HUANG-Haolun/Jerry_Duck/jduck_description/meshes/neck_pitch_link.STL

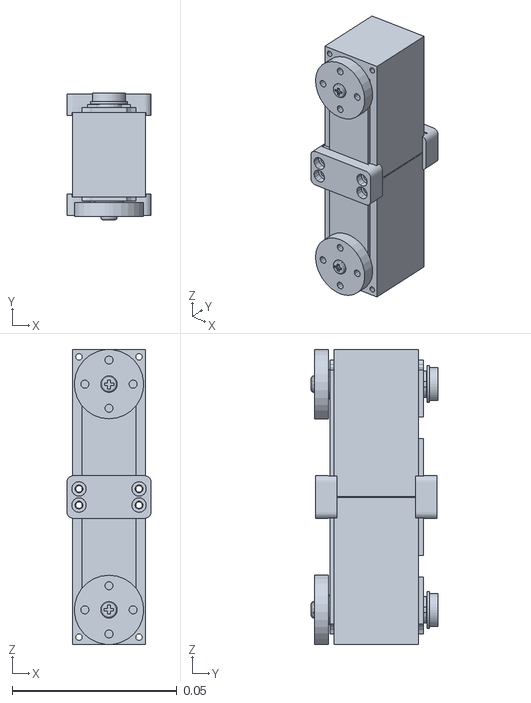
[picture p1: CAD file, 2026-11-02]
jduck_description/meshes/neck_pitch_link.STL
0.0255 x 0.0384 x 0.0894
