HUANG-Haolun/Jerry_Duck/jduck_description/meshes/head_yaw_link.STL

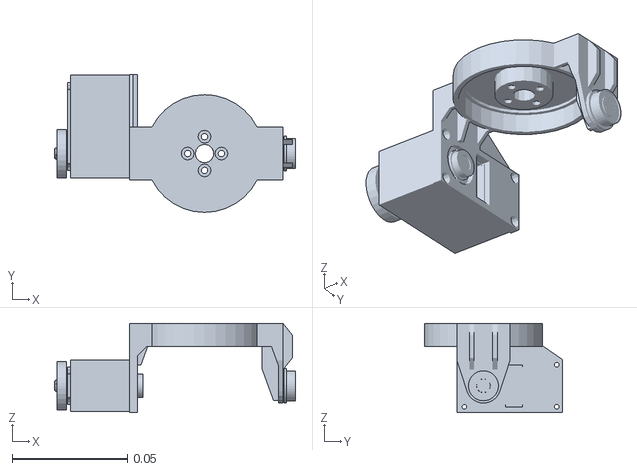
[picture p2: CAD file, 2026-11-02]
jduck_description/meshes/head_yaw_link.STL
0.104 x 0.0597 x 0.0386
