HUANG-Haolun/Jerry_Duck/jduck_description/meshes/mouth_link.STL

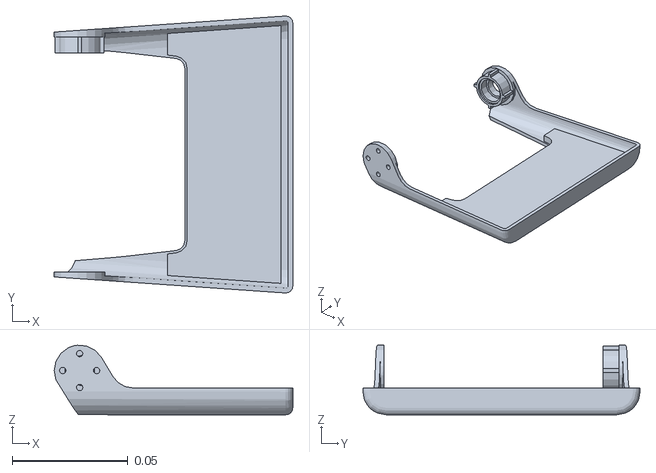
[picture p3: CAD file, 2026-11-02]
jduck_description/meshes/mouth_link.STL
0.103 x 0.12 x 0.0301
