HUANG-Haolun/Jerry_Duck/jduck_description/meshes/right_hip_roll_link.STL

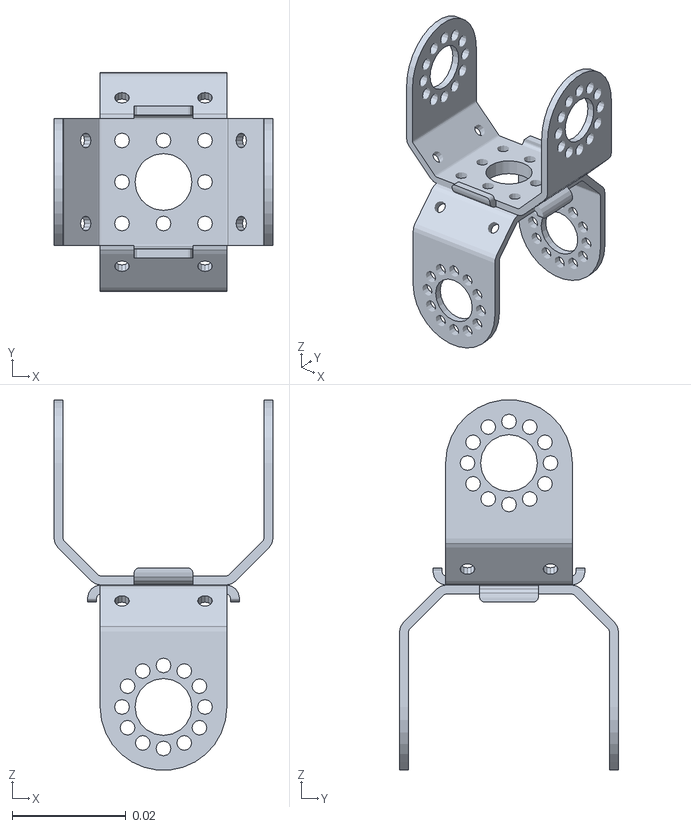
[picture p4: CAD file, 2026-11-02]
jduck_description/meshes/right_hip_roll_link.STL
0.0385 x 0.0385 x 0.0651
