HUANG-Haolun/Jerry_Duck/jduck_description/meshes/right_knee_link.STL

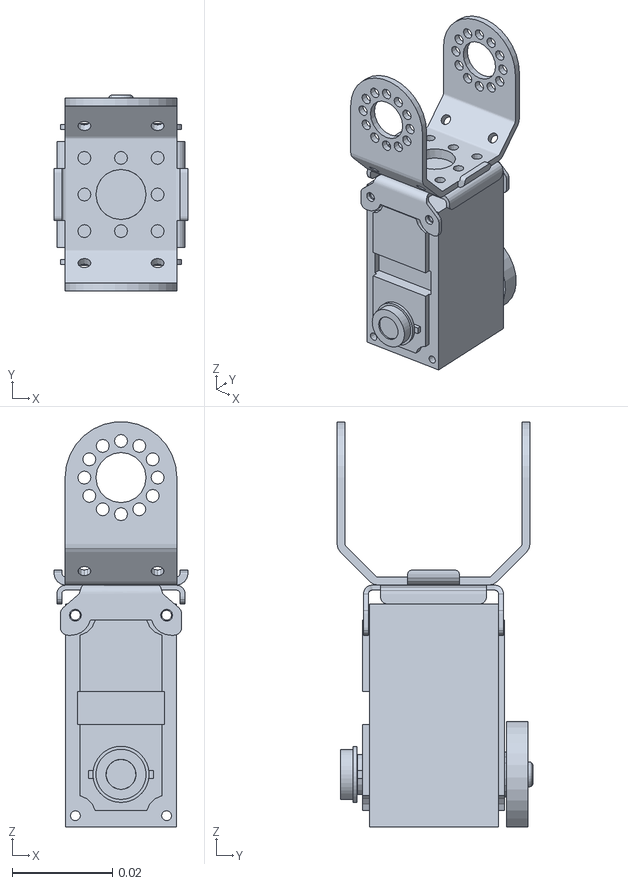
[picture p5: CAD file, 2026-11-02]
jduck_description/meshes/right_knee_link.STL
0.0267 x 0.0391 x 0.0808
