HUANG-Haolun/Jerry_Duck/jduck_description/meshes/base_link.STL

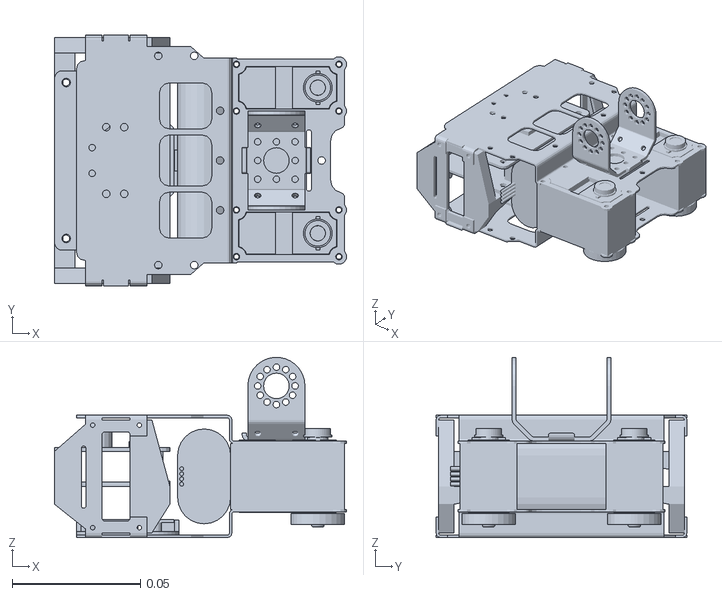
[picture p6: CAD file, 2026-11-02]
jduck_description/meshes/base_link.STL
0.114 x 0.0978 x 0.0702
