HUANG-Haolun/Jerry_Duck/jduck_description/meshes/right_hip_yaw_link.STL

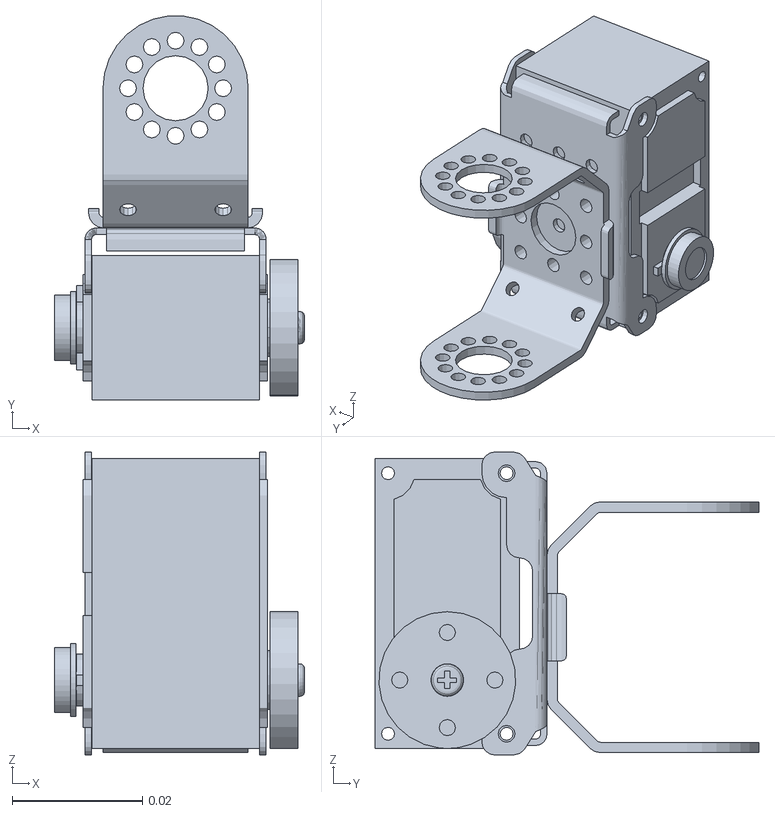
[picture p7: CAD file, 2026-11-02]
jduck_description/meshes/right_hip_yaw_link.STL
0.0384 x 0.0589 x 0.0465
