HUANG-Haolun/Jerry_Duck/jduck_description/meshes/left_ankle_link.STL

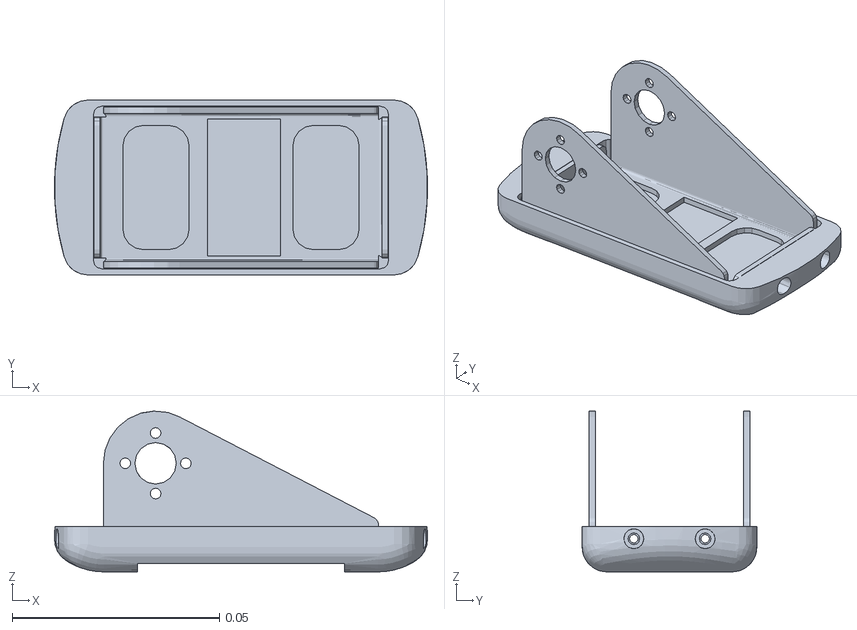
[picture p8: CAD file, 2026-11-02]
jduck_description/meshes/left_ankle_link.STL
0.09 x 0.0422 x 0.0388
