HUANG-Haolun/Jerry_Duck/jduck_description/meshes/right_hip_pitch_link.STL

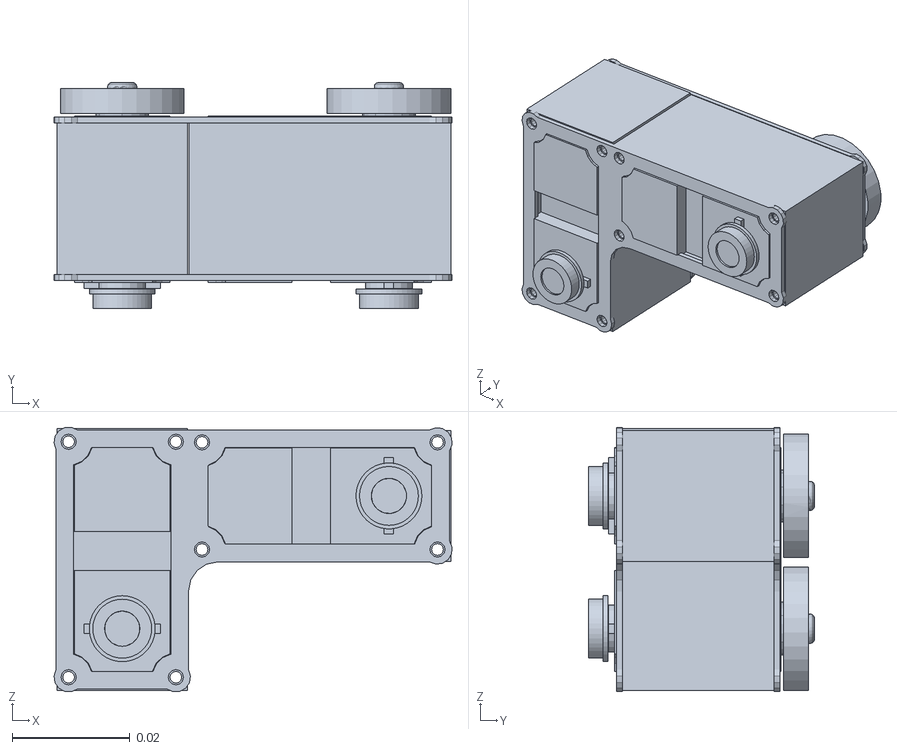
[picture p9: CAD file, 2026-11-02]
jduck_description/meshes/right_hip_pitch_link.STL
0.0676 x 0.0384 x 0.0449
