HUANG-Haolun/Jerry_Duck/jduck_description/meshes/IMU_link.STL

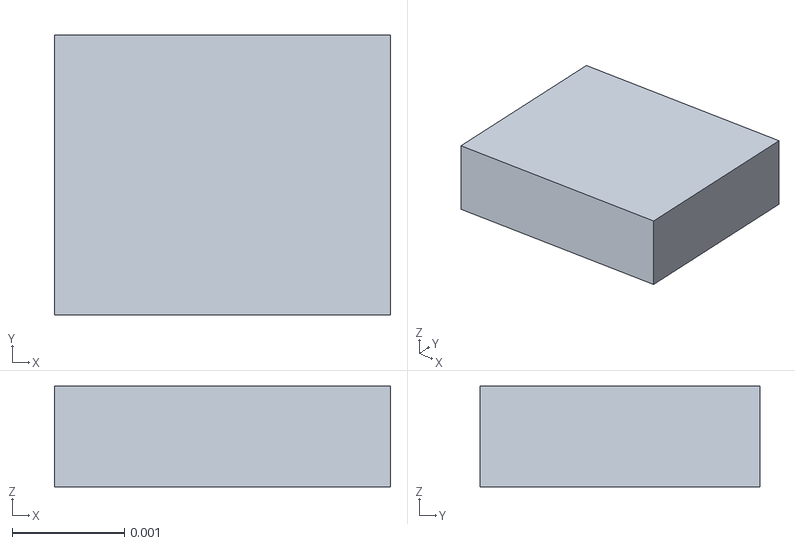
[picture p10: CAD file, 2026-11-02]
jduck_description/meshes/IMU_link.STL
0.003 x 0.0025 x 0.0009
