HUANG-Haolun/Jerry_Duck/jduck_description/meshes/head_roll_link.STL

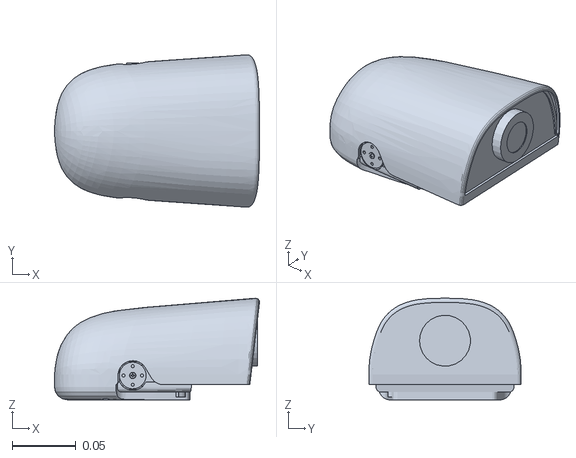
[picture p11: CAD file, 2026-11-02]
jduck_description/meshes/head_roll_link.STL
0.161 x 0.12 x 0.0798
