HUANG-Haolun/Jerry_Duck/jduck_description/meshes/head_pitch_link.STL

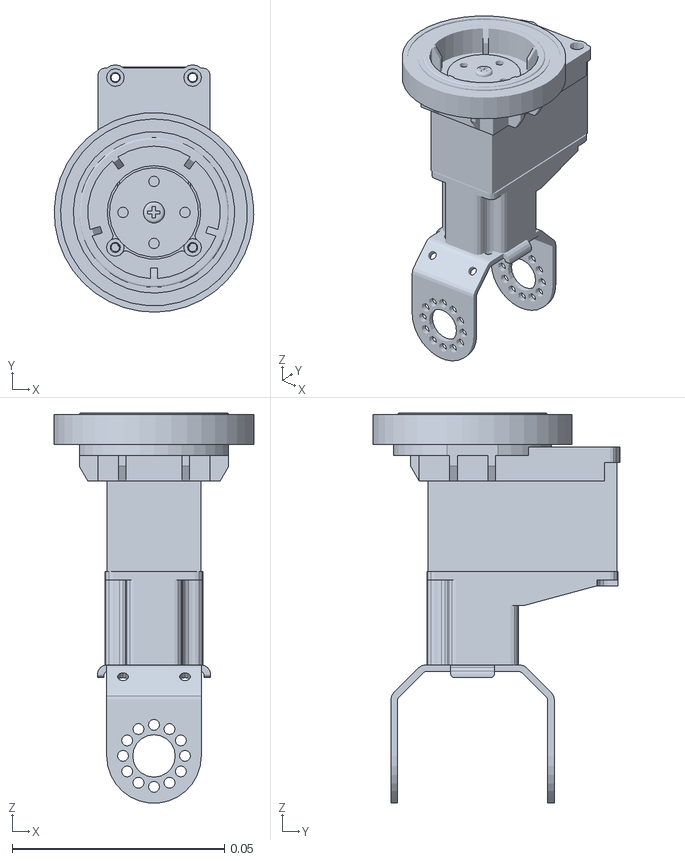
[picture p12: CAD file, 2026-11-02]
jduck_description/meshes/head_pitch_link.STL
0.047 x 0.0582 x 0.0918
