HUANG-Haolun/Jerry_Duck/(list of files, cad)

Other CAD files:
jduck_description/meshes/left_hip_roll_link.STL
jduck_description/meshes/left_knee_link.STL
jduck_description/meshes/left_hip_yaw_link.STL
jduck_description/meshes/left_hip_pitch_link.STL
jduck_description/meshes/right_ankle_link.STL
