HUANG-Haolun/Jerry_Duck/duck_hw/icm_test.c

#include <stdio.h>
#include <stdint.h>
#include <fcntl.h>
#include <unistd.h>
#include <sys/ioctl.h>
#include <linux/spi/spidev.h>

int main(void)
{
    const char *dev = "/dev/spidev3.0";

    int fd = open(dev, O_RDWR);
    if (fd < 0) {
        perror("open");
        return -1;
    }

    uint8_t mode = SPI_MODE_0;
    uint8_t bits = 8;
    uint32_t speed = 100000;

    ioctl(fd, SPI_IOC_WR_MODE, &mode);
    ioctl(fd, SPI_IOC_WR_BITS_PER_WORD, &bits);
    ioctl(fd, SPI_IOC_WR_MAX_SPEED_HZ, &speed);

    uint8_t tx[2] = {0xF5, 0x00};
    uint8_t rx[2] = {0};

    struct spi_ioc_transfer tr = {
        .tx_buf = (unsigned long)tx,
        .rx_buf = (unsigned long)rx,
        .len = 2,
        .speed_hz = speed,
        .bits_per_word = 8,
    };

    if (ioctl(fd, SPI_IOC_MESSAGE(1), &tr) < 0) {
        perror("SPI");
        return -1;
    }

    printf("RX: %02X %02X\n", rx[0], rx[1]);

    close(fd);
    return 0;
}
