HUANG-Haolun/Jerry_Duck/(commit log)

2026-11-02 init repo
    [IMU_link.STL, base_link.STL, head_pitch_link.STL, head_roll_link.STL, head_yaw_link.STL, jduck_description.csv, jduck_description.urdf, left_ankle_link.STL]
2026-11-02 add jduck mjcf
    [robot_walk.xml, robot_walk_view.xml, scene_view.xml, scene_walk.xml]
2026-11-03 add jduck calibration tool
    [servo_map.yaml]
2026-11-03 rename jduck freejoint
    [robot_walk.xml, robot_walk_view.xml]
2026-11-03 import friend's joint limits
    [calibration.yaml, servo_map.yaml]
2026-11-03 add jduck onboard runner, imu driver, sim robot
2026-11-03 add servo law screen
2026-11-03 calibrate: add speed-test
2026-11-03 add the servo firmware
2026-11-03 CLAUDE.md: servo firmware notes
2026-11-03 jduck: URDF limits = friend's table minus 2 deg
    [calibration.yaml, jduck_description.urdf, robot_walk.xml, robot_walk_view.xml]
2026-11-06 sim_robot: current firmware defaults, jitter/yaw readout
    [sim_robot.py]
2026-11-06 hw_chain_eval: 15 s, jitter over 5-15 s
    [hw_chain_eval.py]
2026-11-06 jduck_run: apply the policy's qd filter from ONNX metadata
2026-11-07 添加硬件测试程序和使用说明
2026-11-08 Update servo test for parameterized 10 Hz serial commands
2026-11-08 Query servo by ID at 10 Hz and display TX and RX together
2026-11-09 sim_robot/hw_chain_eval: joint friction option
2026-11-09 calibrate: friction and drop subcommands
2026-11-09 jduck_mjcf: groundcontact model (body collides with the floor)
    [robot_groundcontact.xml, scene_groundcontact.xml]
2026-11-09 CLAUDE.md: groundcontact model
2026-11-09 jduck_mjcf: groundcontact viewer scene
    [robot_groundcontact_view.xml, scene_groundcontact_view.xml]
2026-11-09 jduck_run: switch to get-up policy after a fall; get-up model
2026-11-10 jduck_run --log, jitter_compare, zero-offset sim
    [hw_chain_eval.py, jduck_run.py, jitter_compare.py, sim_robot.py]
2026-11-10 kick model, jduck ball scene
    [scene_ball_view.xml]
2026-11-10 real_calib: calibrate sim_robot against a robot stand log
2026-11-10 calib_stand_eval: zero-cmd stand in the robot-calibrated sim
2026-11-10 calib_stand_eval: walking battery
2026-11-10 long-run: train stock-fw walking until the calibrated-sim gate passes
2026-11-10 jduck_tools: board runtime (ICM-42688 SPI, codex's runner) + run_robot.sh / setup_board.sh; README
2026-11-10 CLAUDE.md: robot runtime, ICM-42688, calibrated-sim gate
2026-11-10 long-run: O5 (board speed range, tight lin std)
2026-11-10 long-run: O7 (tighter yaw and lin stds)
2026-11-10 O8d: stock-firmware walking policy that passes the calibrated-sim gate
2026-11-11 long-run O10: torque DR 0.8–1.6 N·m, gate at 0.9 and 1.4
2026-11-11 long-run O11: spec-sheet servo torque, gate at 0.8/0.96 + stance check
